DBG-Robots/Rosie/production/bom.csv

Designator | Footprint | Quantity | Value | LCSC Part #
BZ1 | Buzzer_Huaneng_MLT-8530 | 1 | MLT-8530 | C94599
C1 | 0603 | 1 | 10uF
C16, C2, C23, C36, C40, C44 | 0402 | 6 | 100nF
C17, C18, C21, C25, C26, C29, C30, C43 | 0805 | 8 | 22uF
C22, C27, C31, C32, C33, C34, C35, C39, C45, C46, C47 | 0805 | 11 | 10uF
C24, C48 | 0402 | 2 | 4.7nF
C28, C38, C42 | 0402 | 3 | 10nF
C3 | 0402 | 1 | 1uF
C37, C41 | 0402 | 2 | 2.2uF
D10, D2, D9 | 0805 | 3 | green | C2297
D11, D13 | 0603 | 2 | red | C2286
D12 | 0805 | 1 | yellow | C2296
D3 | LED_WS2812B_PLCC4_5.0x5.0mm_P3.2mm | 1 | XL-5050RGBC-2812B | C48586674
D4, D5 | D_SOD-323 | 2 | 1N4148WS | C2128
D6, D7, D8 | D_SMA | 3 | SS34 | C8678
F1 | 1812 | 1 | ASMD1812-300 | C135366
J1 | USB_C_Receptacle_HRO_TYPE-C-31-M-12 | 1 | TYPE-C-31-M-12 | C165948
J10 | PinHeader_1x03_P2.54mm_Vertical | 1 | SERVO2 | C42431788 (cut to length)
J11 | PinHeader_1x04_P2.54mm_Vertical | 1 | UART_LIDAR | C42431788 (cut to length)
J12 | PinHeader_1x06_P2.54mm_Vertical | 1 | GPIO | C42431788 (cut to length)
J2 | JST_XH_B2B-XH-A_1x02_P2.50mm_Vertical | 1 | BATT 4xAA | C2908600
J3 | JST_ZH_B6B-ZR_1x06_P1.50mm_Vertical | 1 | MOTOR1 | C157984
J4 | JST_ZH_B6B-ZR_1x06_P1.50mm_Vertical | 1 | MOTOR2 | C157984
J5 | JST_ZH_B6B-ZR_1x06_P1.50mm_Vertical | 1 | MOTOR3 | C157984
J6 | JST_ZH_B6B-ZR_1x06_P1.50mm_Vertical | 1 | MOTOR4 | C157984
J7 | JST_SH_SM04B-SRSS-TB_1x04-1MP_P1.00mm_Horizontal | 1 | QWIIC | C160404
J8 | PinHeader_1x04_P2.54mm_Vertical | 1 | I2C_2 | C42431788 (cut to length)
J9 | PinHeader_1x03_P2.54mm_Vertical | 1 | SERVO1 | C42431788 (cut to length)
L1, L2 | L_Changjiang_FNR4030S | 2 | 1uH | C167865
Q1, Q2 | SOT-23 | 2 | AO3401A | C15127
Q3 | SOT-23 | 1 | MMBT3904 | C20526
R1, R2, R30, R33, R39 | 0402 | 5 | 10k
R10, R9 | 0402 | 2 | 5.1k
R13, R40 | 0402 | 2 | 200k
R14, R17, R41 | 0402 | 3 | 100k
R24 | 0402 | 1 | 47k
R25, R27 | 0402 | 2 | 15k
R26, R38, R42, R43, R44, R45, R46, R47, R48, R49, R50, R51, R52, R53, R54, R55, R56, R57, R58, R61, R63 | 0402 | 21 | 1k
R28 | 0402 | 1 | 2k
R29 | 0402 | 1 | 12k
R31, R32, R34, R35 | 1206 | 4 | 0.2Ω
R36, R37, R59, R60 | 0402 | 4 | 4.7k
R62 | 0402 | 1 | 470
SW1 | SW_Push_1P1T_XKB_TS-1187A | 1 | EN | C318884
SW2 | SW_Push_1P1T_XKB_TS-1187A | 1 | BOOT | C318884
SW3 | SW_Slide_SPDT_Angled_CK_OS102011MA1Q | 1 | SK12D07VG4 | C393937
U1 | SOT-23-6 | 1 | USBLC6-2SC6 | C7519
U10 | WSON-8-1EP_2x2mm_P0.5mm_EP0.9x1.6mm | 1 | TPS259571DSG | C471038
U3 | VQFN-16-1EP_3x3mm_P0.5mm_EP1.68x1.68mm_ThermalVias_D0.3 | 1 | TPS62130A | C337502
U4 | SOT-563_TI_DRL | 1 | TPS61023DRL | C919459
U5, U7 | SOT-23-5 | 2 | SY6280AAC | C55136
U6 | ESP32-S3-WROOM-1_HandSolder | 1 | ESP32-S3-WROOM-1-N8R2
U8, U9 | HTSSOP-16-1EP_4.4x5mm_P0.65mm_EP3.4x5mm_ThermalVias_D0.3 | 2 | DRV8833PWP | C50506
