DBG-Robots/Rosie/Rosie.kicad_pcb

## KiCad design Rosie.kicad_pcb (2026-11-05)

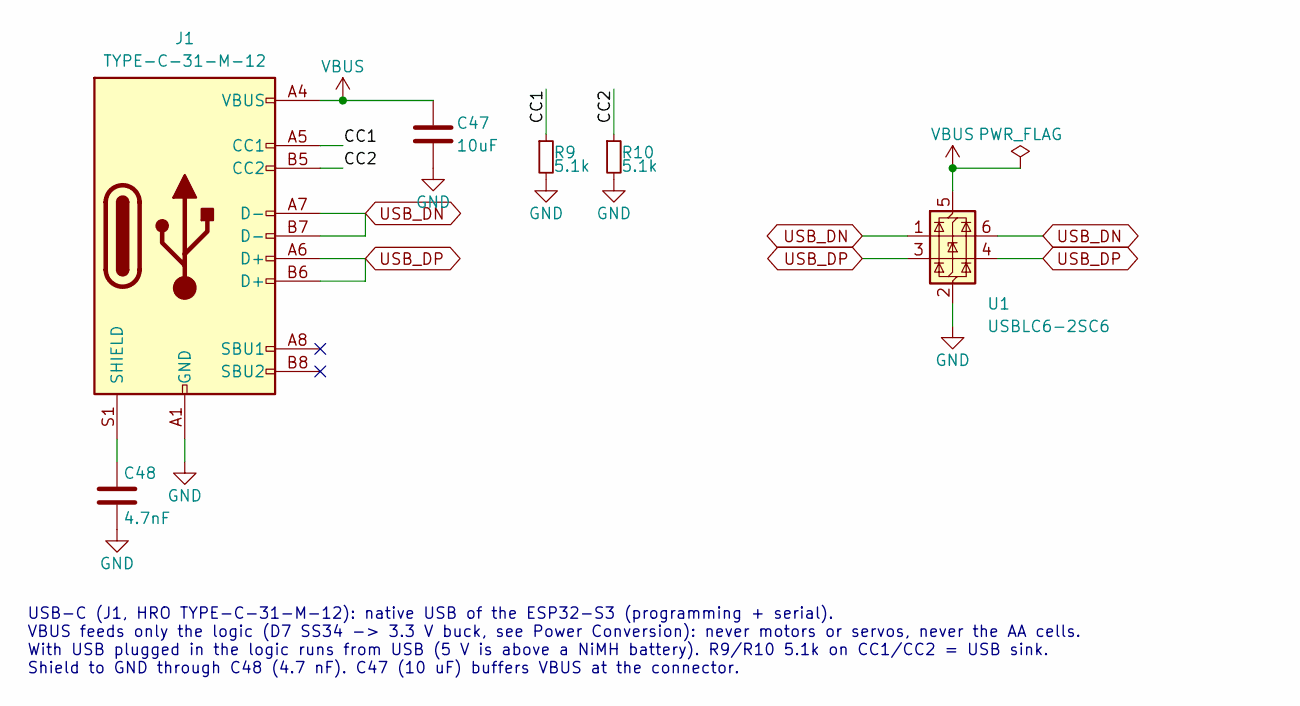
[picture p2: schematic usb.kicad_sch, Rosie]

Parts:
C47: 10uF; C_0805_2012Metric
C48: 4.7nF; C_0402_1005Metric
J1: TYPE-C-31-M-12; USB_C_Receptacle_HRO_TYPE-C-31-M-12; LCSC Part C165948
R9, R10: 5.1k; R_0402_1005Metric
U1: USBLC6-2SC6; SOT-23-6; LCSC Part C7519

Connections:
/USB/CC1: J1.A5 (CC1), R9.1
/USB/CC2: J1.B5 (CC2), R10.1
GND: C47.2, C48.2, J1.A1 (GND), J1.A12 (GND), J1.B1 (GND), J1.B12 (GND), R9.2, R10.2, U1.2 (GND); also elsewhere on the board
unnamed: C48.1, J1.S1 (SHIELD)
USB_DN: J1.A7 (D-), J1.B7 (D-), U1.1 (I/O1), U1.6 (I/O1); also elsewhere on the board
USB_DP: J1.A6 (D+), J1.B6 (D+), U1.3 (I/O2), U1.4 (I/O2); also elsewhere on the board
VBUS: C47.1, J1.A4 (VBUS), J1.A9 (VBUS), J1.B4 (VBUS), J1.B9 (VBUS), U1.5 (VBUS); also elsewhere on the board

Notes on the sheet:
USB-C (J1, HRO TYPE-C-31-M-12): native USB of the ESP32-S3 (programming + serial). VBUS feeds only the logic (D7 SS34 -> 3.3 V buck, see Power Conversion): never motors or servos, never the AA cells. With USB plugged in the logic runs from USB (5 V is above a NiMH battery). R9/R10 5.1k on CC1/CC2 =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

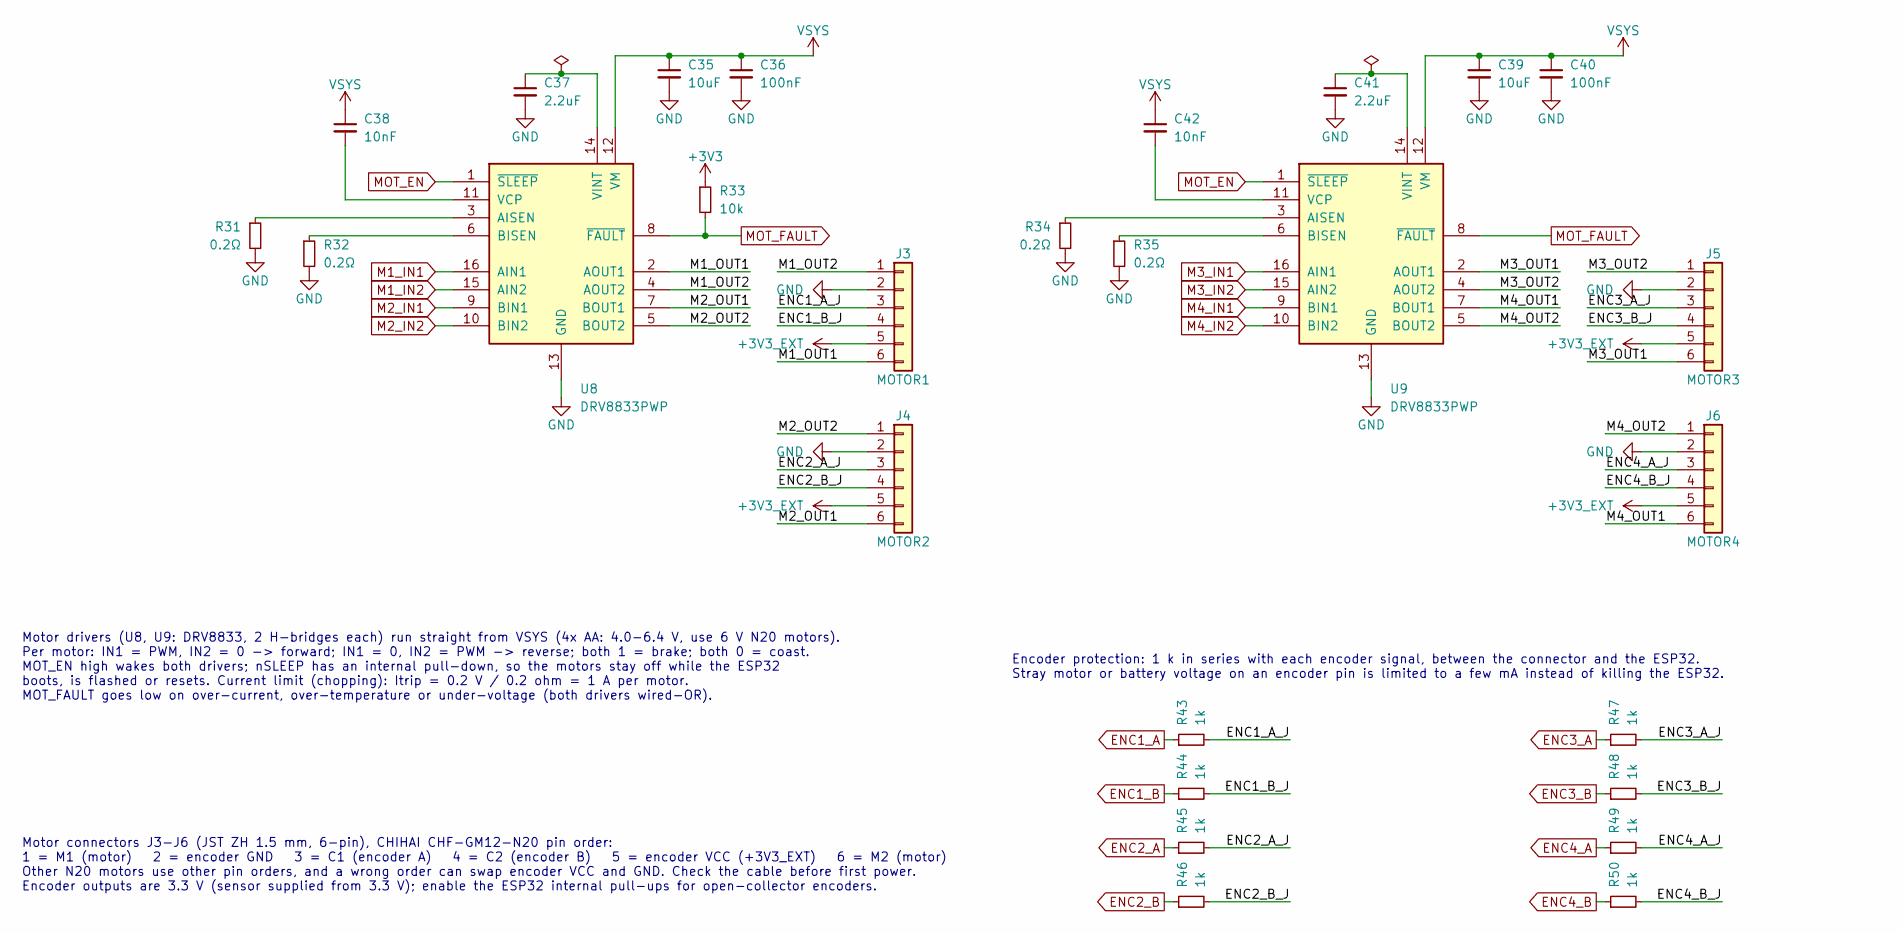
[picture p3: schematic motor_drivers.kicad_sch, Rosie]

Parts:
C35, C39: 10uF; C_0805_2012Metric
C36, C40: 100nF; C_0402_1005Metric
C37, C41: 2.2uF; C_0402_1005Metric
C38, C42: 10nF; C_0402_1005Metric
J3: MOTOR1; JST_ZH_B6B-ZR_1x06_P1.50mm_Vertical; LCSC Part C157984
J4: MOTOR2; JST_ZH_B6B-ZR_1x06_P1.50mm_Vertical; LCSC Part C157984
J5: MOTOR3; JST_ZH_B6B-ZR_1x06_P1.50mm_Vertical; LCSC Part C157984
J6: MOTOR4; JST_ZH_B6B-ZR_1x06_P1.50mm_Vertical; LCSC Part C157984
R31, R32, R34, R35: 0.2Ω; R_1206_3216Metric
R33: 10k; R_0402_1005Metric
R43, R44, R45, R46, R47, R48, R49, R50: 1k; R_0402_1005Metric
U8, U9: DRV8833PWP; HTSSOP-16-1EP_4.4x5mm_P0.65mm_EP3.4x5mm_ThermalVias_D0.3; LCSC Part C50506

Connections:
+3V3: R33.1; also elsewhere on the board
+3V3_EXT: J3.5, J4.5, J5.5, J6.5; also elsewhere on the board
/Motor Drivers/ENC1_A_J: J3.3, R43.2
/Motor Drivers/ENC1_B_J: J3.4, R44.2
/Motor Drivers/ENC2_A_J: J4.3, R45.2
/Motor Drivers/ENC2_B_J: J4.4, R46.2
/Motor Drivers/ENC3_A_J: J5.3, R47.2
/Motor Drivers/ENC3_B_J: J5.4, R48.2
/Motor Drivers/ENC4_A_J: J6.3, R49.2
/Motor Drivers/ENC4_B_J: J6.4, R50.2
/Motor Drivers/M1_OUT1: J3.6, U8.2 (AOUT1)
/Motor Drivers/M1_OUT2: J3.1, U8.4 (AOUT2)
/Motor Drivers/M2_OUT1: J4.6, U8.7 (BOUT1)
/Motor Drivers/M2_OUT2: J4.1, U8.5 (BOUT2)
/Motor Drivers/M3_OUT1: J5.6, U9.2 (AOUT1)
/Motor Drivers/M3_OUT2: J5.1, U9.4 (AOUT2)
/Motor Drivers/M4_OUT1: J6.6, U9.7 (BOUT1)
/Motor Drivers/M4_OUT2: J6.1, U9.5 (BOUT2)
ENC1_A: R43.1; also elsewhere on the board
ENC1_B: R44.1; also elsewhere on the board
ENC2_A: R45.1; also elsewhere on the board
ENC2_B: R46.1; also elsewhere on the board
ENC3_A: R47.1; also elsewhere on the board
ENC3_B: R48.1; also elsewhere on the board
ENC4_A: R49.1; also elsewhere on the board
ENC4_B: R50.1; also elsewhere on the board
GND: C35.2, C36.2, C37.2, C39.2, C40.2, C41.2, J3.2, J4.2, J5.2, J6.2, R31.2, R32.2, R34.2, R35.2, U8.13 (GND), U8.17 (GND), U9.13 (GND), U9.17 (GND); also elsewhere on the board
M1_IN1: U8.16 (AIN1); also elsewhere on the board
M1_IN2: U8.15 (AIN2); also elsewhere on the board
M2_IN1: U8.9 (BIN1); also elsewhere on the board
M2_IN2: U8.10 (BIN2); also elsewhere on the board
M3_IN1: U9.16 (AIN1); also elsewhere on the board
M3_IN2: U9.15 (AIN2); also elsewhere on the board
M4_IN1: U9.9 (BIN1); also elsewhere on the board
M4_IN2: U9.10 (BIN2); also elsewhere on the board
MOT_EN: U8.1 (~SLEEP), U9.1 (~SLEEP); also elsewhere on the board
MOT_FAULT: R33.2, U8.8 (~FAULT), U9.8 (~FAULT); also elsewhere on the board
unnamed: R31.1, U8.3 (AISEN)
unnamed: R32.1, U8.6 (BISEN)
unnamed: C38.2, U8.11 (VCP)
unnamed: C37.1, U8.14 (VINT)
unnamed: R34.1, U9.3 (AISEN)
unnamed: R35.1, U9.6 (BISEN)
unnamed: C42.2, U9.11 (VCP)
unnamed: C41.1, U9.14 (VINT)
VSYS: C35.1, C36.1, C38.1, C39.1, C40.1, C42.1, U8.12 (VM), U9.12 (VM); also elsewhere on the board

Notes on the sheet:
Encoder protection: 1 k in series with each encoder signal, between the connector and the ESP32. Stray motor or battery voltage on an encoder pin is limited to a few mA instead of killing the ESP32.
Motor connectors J3-J6 (JST ZH 1.5 mm, 6-pin), CHIHAI CHF-GM12-N20 pin order: 1 = M1 (motor) 2 = encoder GND 3 = C1 (encoder A) 4 = C2 (encoder B) 5 = encoder VCC (+3V3_EXT) 6 = M2 (motor) Other N20 motors use other pin orders, and a wrong order can swap encoder VCC and GND. Check the cable before 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
Motor drivers (U8, U9: DRV8833, 2 H-bridges each) run straight from VSYS (4x AA: 4.0-6.4 V, use 6 V N20 motors). Per motor: IN1 = PWM, IN2 = 0 -> forward; IN1 = 0, IN2 = PWM -> reverse; both 1 = brake; both 0 = coast. MOT_EN high wakes both drivers; nSLEEP has an internal pull-down, so the motors s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

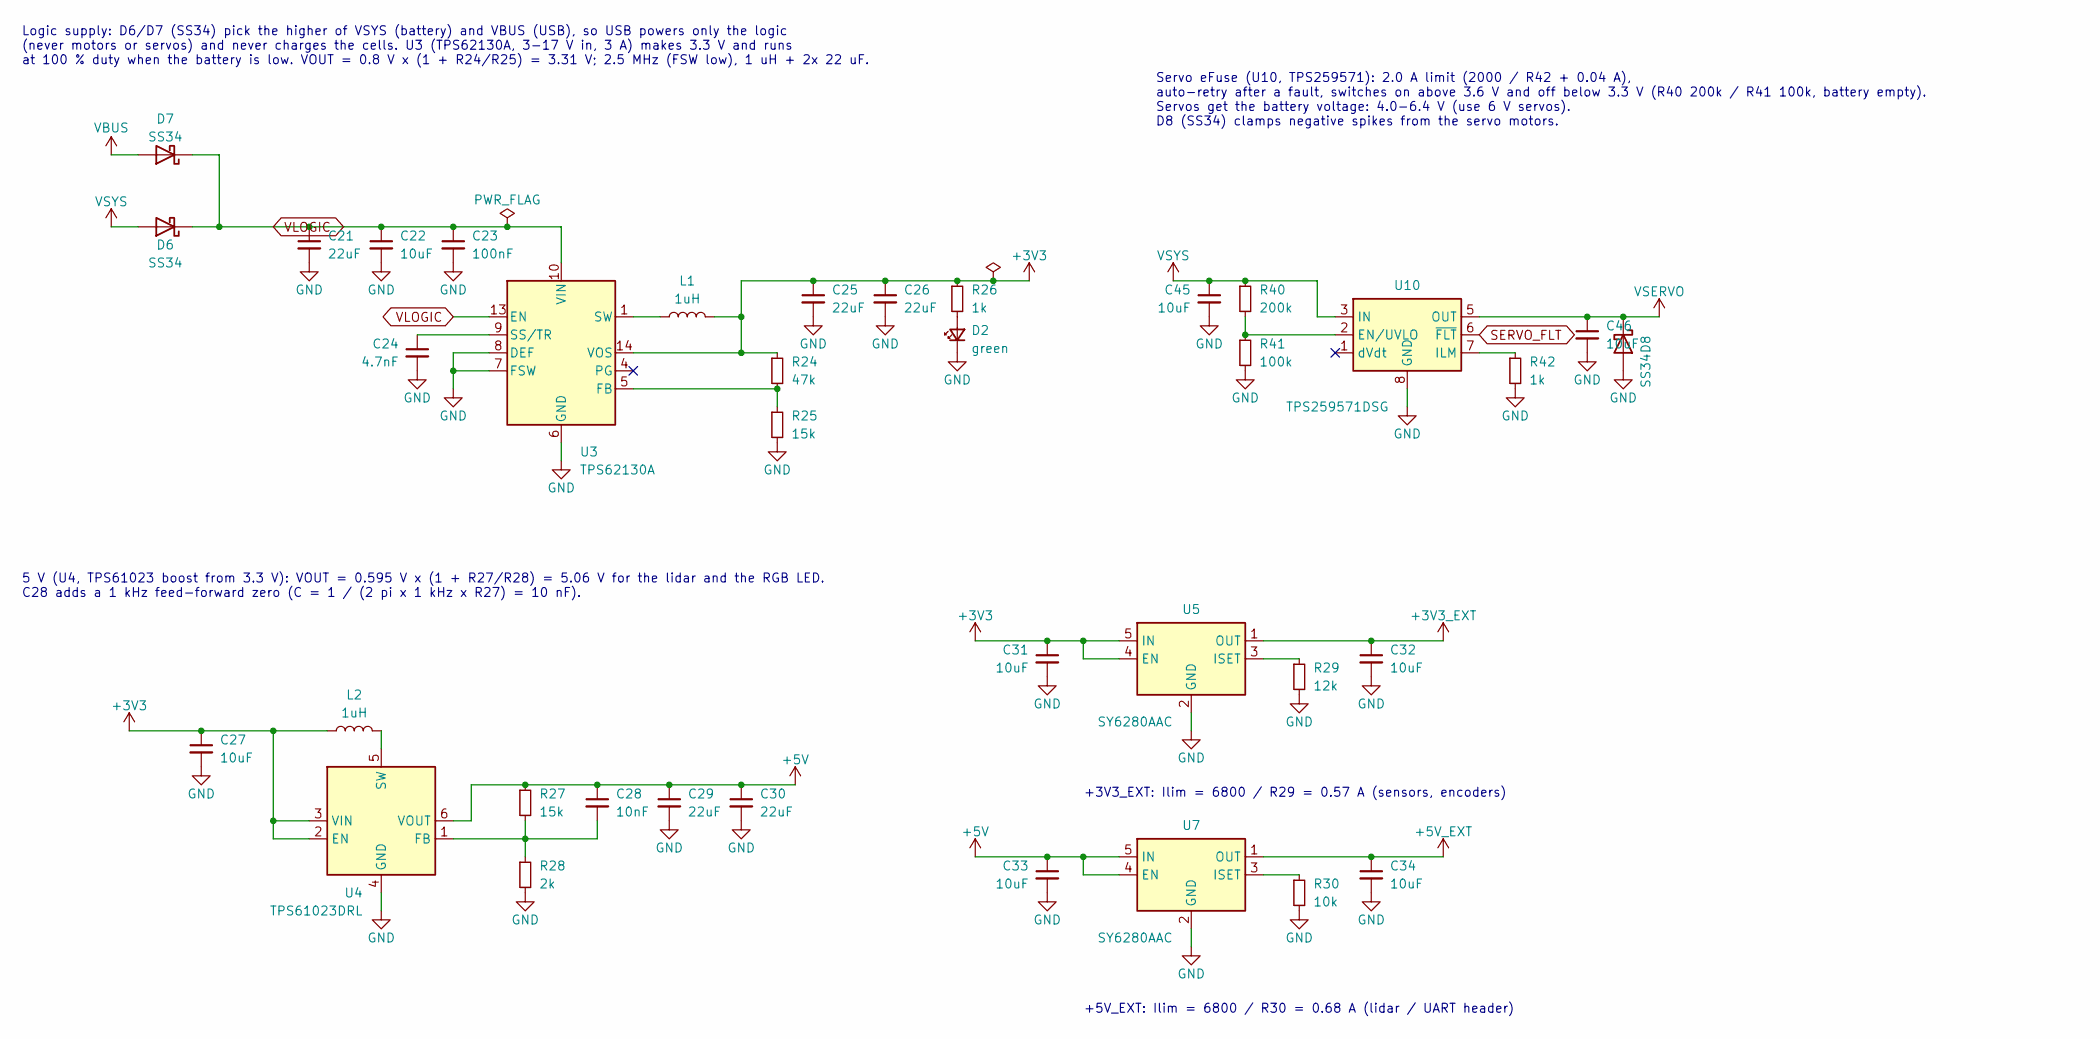
[picture p4: schematic power_conversion.kicad_sch, Rosie]

Parts:
C21, C25, C26, C29, C30: 22uF; C_0805_2012Metric
C22, C27, C31, C32, C33, C34, C45, C46: 10uF; C_0805_2012Metric
C23: 100nF; C_0402_1005Metric
C24: 4.7nF; C_0402_1005Metric
C28: 10nF; C_0402_1005Metric
D2: green; LED_0805_2012Metric; LCSC Part C2297
D6, D7, D8: SS34; D_SMA; LCSC Part C8678
L1, L2: 1uH; L_Changjiang_FNR4030S; LCSC Part C167865
R24: 47k; R_0402_1005Metric
R25, R27: 15k; R_0402_1005Metric
R26, R42: 1k; R_0402_1005Metric
R28: 2k; R_0402_1005Metric
R29: 12k; R_0402_1005Metric
R30: 10k; R_0402_1005Metric
R40: 200k; R_0402_1005Metric
R41: 100k; R_0402_1005Metric
U3: TPS62130A; VQFN-16-1EP_3x3mm_P0.5mm_EP1.68x1.68mm_ThermalVias_D0.3; LCSC Part C337502
U4: TPS61023DRL; SOT-563_TI_DRL; LCSC Part C919459
U5, U7: SY6280AAC; SOT-23-5; LCSC Part C55136
U10: TPS259571DSG; WSON-8-1EP_2x2mm_P0.5mm_EP0.9x1.6mm; LCSC Part C471038

Connections:
+3V3: C25.1, C26.1, C27.1, C31.1, L1.2, L2.1, R24.1, R26.1, U3.14 (VOS), U4.2 (EN), U4.3 (VIN), U5.4 (EN), U5.5 (IN); also elsewhere on the board
+3V3_EXT: C32.1, U5.1 (OUT); also elsewhere on the board
+5V: C28.1, C29.1, C30.1, C33.1, R27.1, U4.6 (VOUT), U7.4 (EN), U7.5 (IN); also elsewhere on the board
+5V_EXT: C34.1, U7.1 (OUT); also elsewhere on the board
GND: C21.2, C22.2, C23.2, C24.2, C25.2, C26.2, C27.2, C29.2, C30.2, C31.2, C32.2, C33.2, C34.2, C45.2, C46.2, D2.1 (K), D8.2 (A), R25.2, R28.2, R29.2, R30.2, R41.2, R42.2, U3.6 (GND), U3.7 (FSW), U3.8 (DEF), U3.15 (GND), U3.16 (GND), U3.17 (GND), U4.4 (GND), U5.2 (GND), U7.2 (GND), U10.8 (GND), U10.9 (GND); also elsewhere on the board
unnamed: D2.2 (A), R26.2
unnamed: L1.1, U3.1 (SW), U3.2 (SW), U3.3 (SW)
unnamed: R24.2, R25.1, U3.5 (FB)
unnamed: C24.1, U3.9 (SS/TR)
unnamed: C28.2, R27.2, R28.1, U4.1 (FB)
unnamed: L2.2, U4.5 (SW)
unnamed: R29.1, U5.3 (ISET)
unnamed: R30.1, U7.3 (ISET)
unnamed: R40.2, R41.1, U10.2 (EN/UVLO)
unnamed: R42.1, U10.7 (ILM)
SERVO_FLT: U10.6 (~FLT); also elsewhere on the board
VBUS: D7.2 (A); also elsewhere on the board
VLOGIC: C21.1, C22.1, C23.1, D6.1 (K), D7.1 (K), U3.10 (VIN), U3.11 (VIN), U3.12 (VIN), U3.13 (EN); also elsewhere on the board
VSERVO: C46.1, D8.1 (K), U10.5 (OUT); also elsewhere on the board
VSYS: C45.1, D6.2 (A), R40.1, U10.3 (IN), U10.4 (IN); also elsewhere on the board

Notes on the sheet:
5 V (U4, TPS61023 boost from 3.3 V): VOUT = 0.595 V x (1 + R27/R28) = 5.06 V for the lidar and the RGB LED. C28 adds a 1 kHz feed-forward zero (C = 1 / (2 pi x 1 kHz x R27) = 10 nF).
Logic supply: D6/D7 (SS34) pick the higher of VSYS (battery) and VBUS (USB), so USB powers only the logic (never motors or servos) and never charges the cells. U3 (TPS62130A, 3-17 V in, 3 A) makes 3.3 V and runs at 100 % duty when the battery is low. VOUT = 0.8 V x (1 + R24/R25) = 3.31 V; 2.5 MHz (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
Servo eFuse (U10, TPS259571): 2.0 A limit (2000 / R42 + 0.04 A), auto-retry after a fault, switches on above 3.6 V and off below 3.3 V (R40 200k / R41 100k, battery empty). Servos get the battery voltage: 4.0-6.4 V (use 6 V servos). D8 (SS34) clamps negative spikes from the servo motors.
+3V3_EXT: Ilim = 6800 / R29 = 0.57 A (sensors, encoders)
+5V_EXT: Ilim = 6800 / R30 = 0.68 A (lidar / UART header)

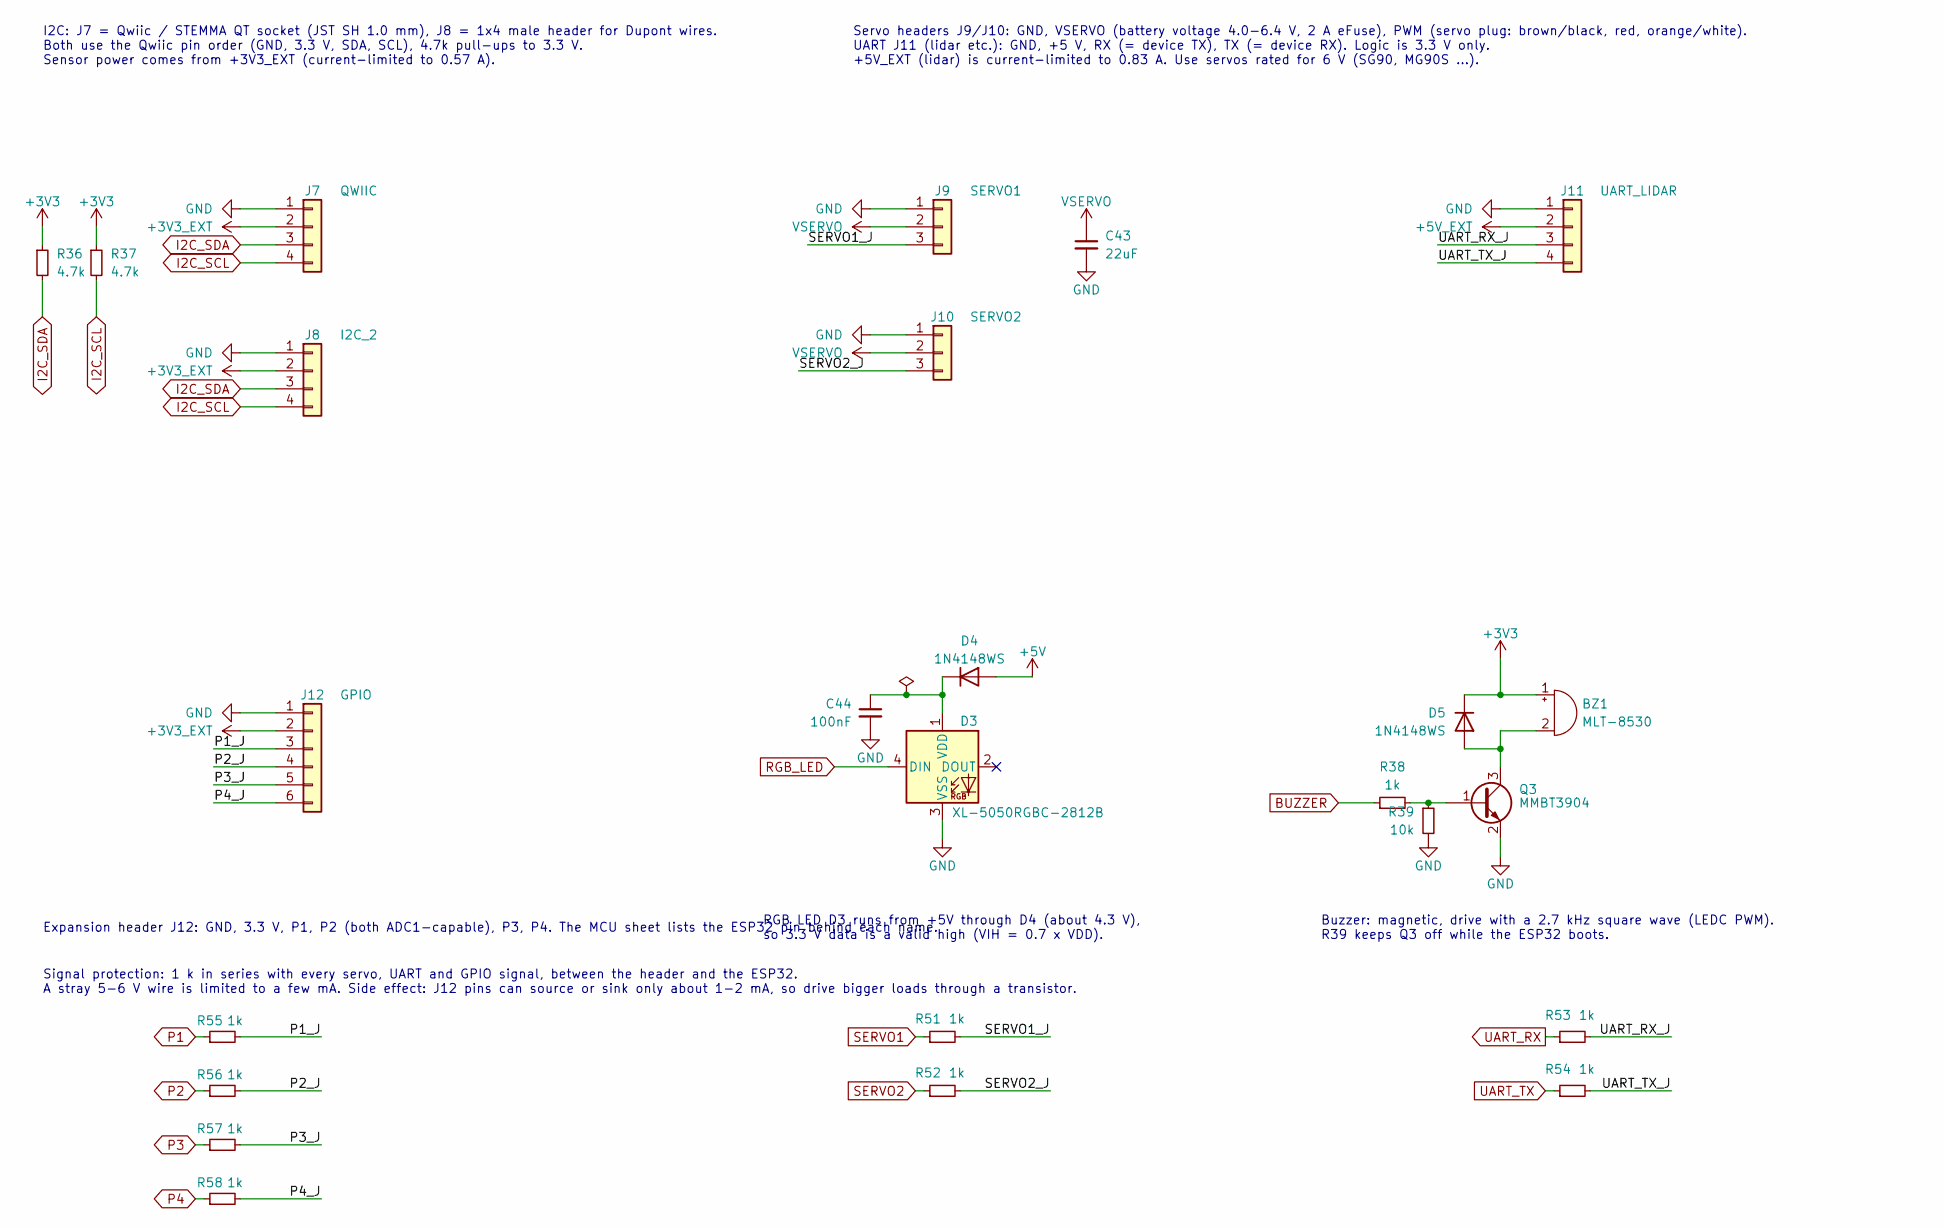
[picture p5: schematic io_peripherals.kicad_sch, Rosie]

Parts:
BZ1: MLT-8530; Buzzer_Huaneng_MLT-8530; LCSC Part C94599
C43: 22uF; C_0805_2012Metric
C44: 100nF; C_0402_1005Metric
D3: XL-5050RGBC-2812B; LED_WS2812B_PLCC4_5.0x5.0mm_P3.2mm; LCSC Part C48586674
D4, D5: 1N4148WS; D_SOD-323; LCSC Part C2128
J7: QWIIC; JST_SH_SM04B-SRSS-TB_1x04-1MP_P1.00mm_Horizontal; LCSC Part C160404
J8: I2C_2; PinHeader_1x04_P2.54mm_Vertical; LCSC Part C42431788 (cut to length)
J9: SERVO1; PinHeader_1x03_P2.54mm_Vertical; LCSC Part C42431788 (cut to length)
J10: SERVO2; PinHeader_1x03_P2.54mm_Vertical; LCSC Part C42431788 (cut to length)
J11: UART_LIDAR; PinHeader_1x04_P2.54mm_Vertical; LCSC Part C42431788 (cut to length)
J12: GPIO; PinHeader_1x06_P2.54mm_Vertical; LCSC Part C42431788 (cut to length)
Q3: MMBT3904; SOT-23; LCSC Part C20526
R36, R37: 4.7k; R_0402_1005Metric
R38, R51, R52, R53, R54, R55, R56, R57, R58: 1k; R_0402_1005Metric
R39: 10k; R_0402_1005Metric

Connections:
+3V3: BZ1.1 (+), D5.1 (K), R36.1, R37.1; also elsewhere on the board
+3V3_EXT: J7.2, J8.2, J12.2; also elsewhere on the board
+5V: D4.2 (A); also elsewhere on the board
+5V_EXT: J11.2; also elsewhere on the board
/IO Peripherals/P1_J: J12.3, R55.2
/IO Peripherals/P2_J: J12.4, R56.2
/IO Peripherals/P3_J: J12.5, R57.2
/IO Peripherals/P4_J: J12.6, R58.2
/IO Peripherals/SERVO1_J: J9.3, R51.2
/IO Peripherals/SERVO2_J: J10.3, R52.2
/IO Peripherals/UART_RX_J: J11.3, R53.2
/IO Peripherals/UART_TX_J: J11.4, R54.2
BUZZER: R38.1; also elsewhere on the board
GND: C43.2, C44.2, D3.3 (VSS), J7.1, J8.1, J9.1, J10.1, J11.1, J12.1, Q3.2 (E), R39.2; also elsewhere on the board
I2C_SCL: J7.4, J8.4, R37.2; also elsewhere on the board
I2C_SDA: J7.3, J8.3, R36.2; also elsewhere on the board
unnamed: BZ1.2 (-), D5.2 (A), Q3.3 (C)
unnamed: C44.1, D3.1 (VDD), D4.1 (K)
unnamed: Q3.1 (B), R38.2, R39.1
P1: R55.1; also elsewhere on the board
P2: R56.1; also elsewhere on the board
P3: R57.1; also elsewhere on the board
P4: R58.1; also elsewhere on the board
RGB_LED: D3.4 (DIN); also elsewhere on the board
SERVO1: R51.1; also elsewhere on the board
SERVO2: R52.1; also elsewhere on the board
UART_RX: R53.1; also elsewhere on the board
UART_TX: R54.1; also elsewhere on the board
VSERVO: C43.1, J9.2, J10.2; also elsewhere on the board

Notes on the sheet:
Buzzer: magnetic, drive with a 2.7 kHz square wave (LEDC PWM). R39 keeps Q3 off while the ESP32 boots.
Servo headers J9/J10: GND, VSERVO (battery voltage 4.0-6.4 V, 2 A eFuse), PWM (servo plug: brown/black, red, orange/white). UART J11 (lidar etc.): GND, +5 V, RX (= device TX), TX (= device RX). Logic is 3.3 V only. +5V_EXT (lidar) is current-limited to 0.83 A. Use servos rated for 6 V (SG90, MG90S 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
Signal protection: 1 k in series with every servo, UART and GPIO signal, between the header and the ESP32. A stray 5-6 V wire is limited to a few mA. Side effect: J12 pins can source or sink only about 1-2 mA, so drive bigger loads through a transistor.
I2C: J7 = Qwiic / STEMMA QT socket (JST SH 1.0 mm), J8 = 1x4 male header for Dupont wires. Both use the Qwiic pin order (GND, 3.3 V, SDA, SCL), 4.7k pull-ups to 3.3 V. Sensor power comes from +3V3_EXT (current-limited to 0.57 A).
RGB LED D3 runs from +5V through D4 (about 4.3 V), so 3.3 V data is a valid high (VIH = 0.7 x VDD).
Expansion header J12: GND, 3.3 V, P1, P2 (both ADC1-capable), P3, P4. The MCU sheet lists the ESP32 pin behind each name.

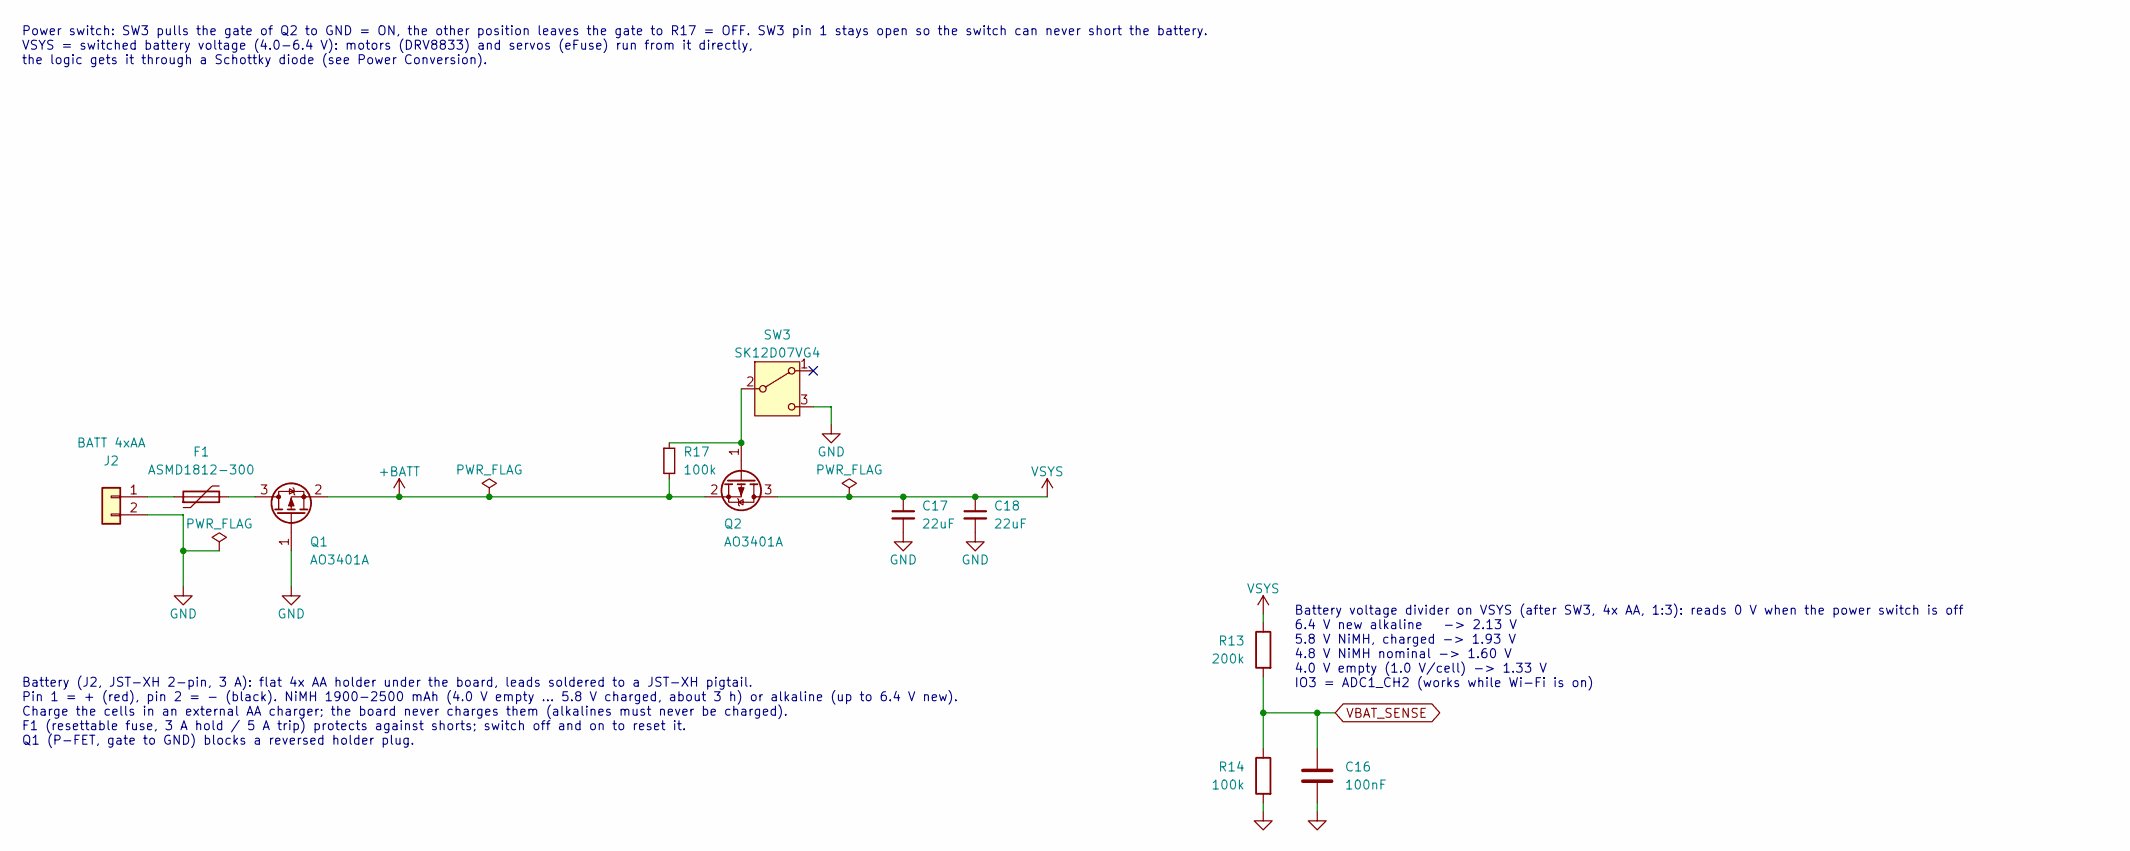
[picture p6: schematic power_input.kicad_sch, Rosie]

Parts:
C16: 100nF; C_0402_1005Metric
C17, C18: 22uF; C_0805_2012Metric
F1: ASMD1812-300; Fuse_1812_4532Metric; LCSC Part C135366
J2: BATT 4xAA; JST_XH_B2B-XH-A_1x02_P2.50mm_Vertical; LCSC Part C2908600
Q1, Q2: AO3401A; SOT-23; LCSC Part C15127
R13: 200k; R_0402_1005Metric
R14, R17: 100k; R_0402_1005Metric
SW3: SK12D07VG4; SW_Slide_SPDT_Angled_CK_OS102011MA1Q; LCSC Part C393937

Connections:
+BATT: Q1.2 (S), Q2.2 (S), R17.2; also elsewhere on the board
GND: C16.2, C17.2, C18.2, J2.2, Q1.1 (G), R14.2, SW3.3 (C); also elsewhere on the board
unnamed: F1.1, J2.1
unnamed: F1.2, Q1.3 (D)
unnamed: Q2.1 (G), R17.1, SW3.2 (B)
VBAT_SENSE: C16.1, R13.2, R14.1; also elsewhere on the board
VSYS: C17.1, C18.1, Q2.3 (D), R13.1; also elsewhere on the board

Notes on the sheet:
Power switch: SW3 pulls the gate of Q2 to GND = ON, the other position leaves the gate to R17 = OFF. SW3 pin 1 stays open so the switch can never short the battery. VSYS = switched battery voltage (4.0-6.4 V): motors (DRV8833) and servos (eFuse) run from it directly, the logic gets it through a Sch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
Battery voltage divider on VSYS (after SW3, 4x AA, 1:3): reads 0 V when the power switch is off 6.4 V new alkaline -> 2.13 V 5.8 V NiMH, charged -> 1.93 V 4.8 V NiMH nominal -> 1.60 V 4.0 V empty (1.0 V/cell) -> 1.33 V IO3 = ADC1_CH2 (works while Wi-Fi is on)
Battery (J2, JST-XH 2-pin, 3 A): flat 4x AA holder under the board, leads soldered to a JST-XH pigtail. Pin 1 = + (red), pin 2 = - (black). NiMH 1900-2500 mAh (4.0 V empty ... 5.8 V charged, about 3 h) or alkaline (up to 6.4 V new). Charge the cells in an external AA charger; the board never charge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

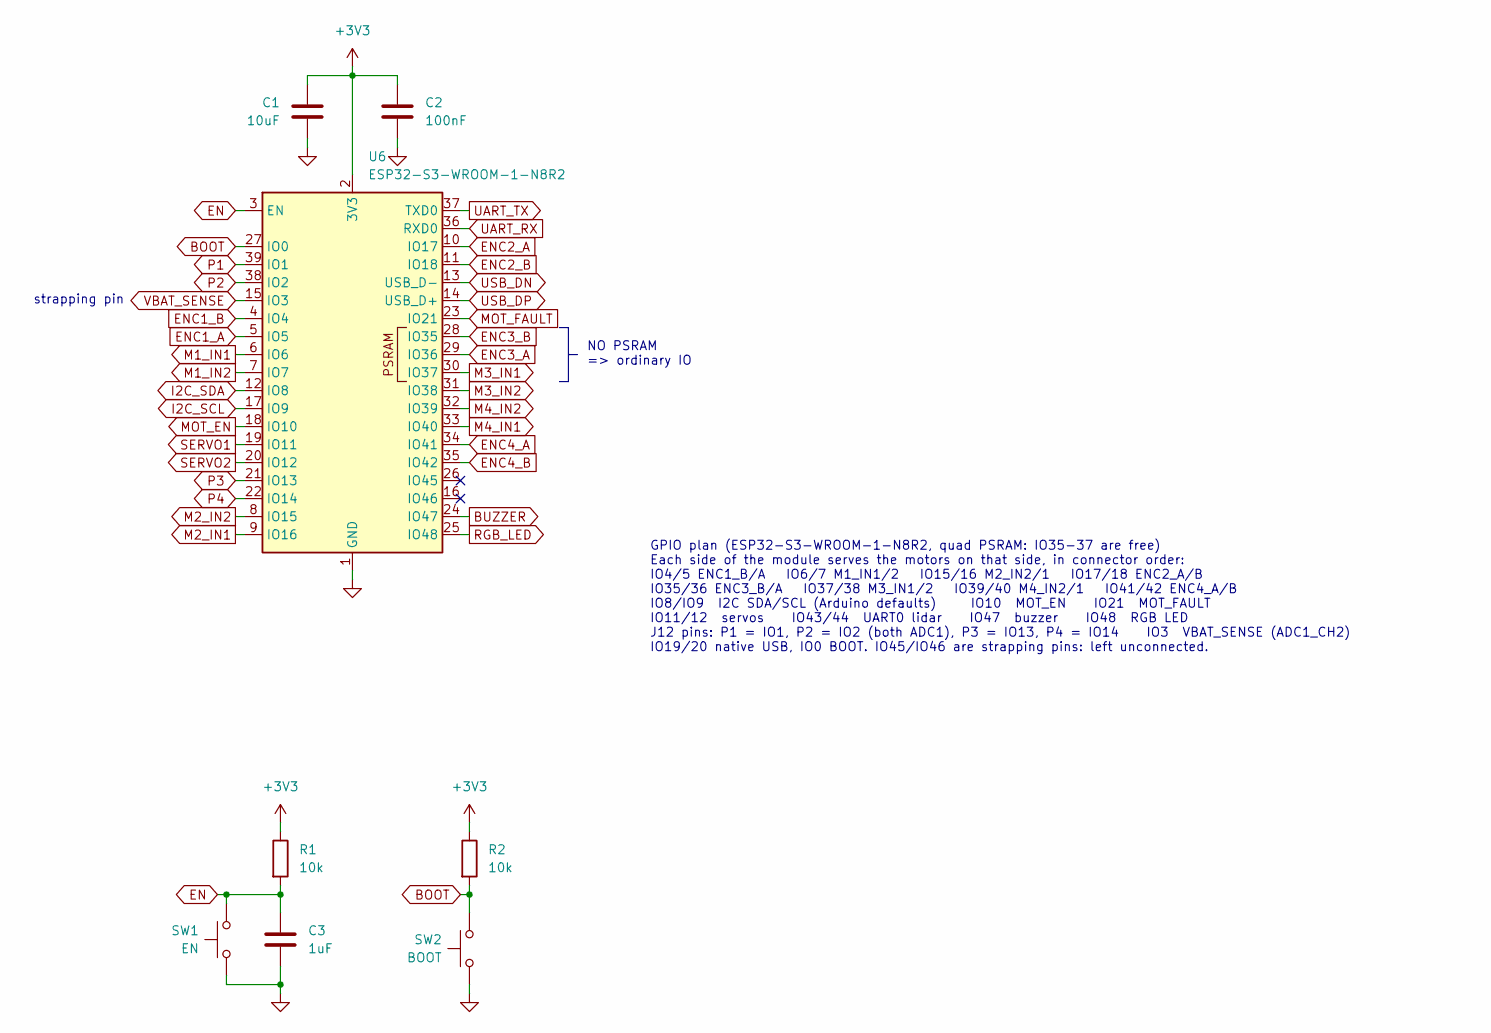
[picture p7: schematic mcu.kicad_sch, Rosie]

Parts:
C1: 10uF; C_0603_1608Metric
C2: 100nF; C_0402_1005Metric
C3: 1uF; C_0402_1005Metric
R1, R2: 10k; R_0402_1005Metric
SW1: EN; SW_Push_1P1T_XKB_TS-1187A; LCSC Part C318884
SW2: BOOT; SW_Push_1P1T_XKB_TS-1187A; LCSC Part C318884
U6: ESP32-S3-WROOM-1-N8R2; ESP32-S3-WROOM-1_HandSolder

Connections:
+3V3: C1.1, C2.1, R1.1, R2.1, U6.2 (3V3); also elsewhere on the board
BOOT: R2.2, SW2.2, U6.27 (IO0); also elsewhere on the board
BUZZER: U6.24 (IO47); also elsewhere on the board
EN: C3.1, R1.2, SW1.2, U6.3 (EN); also elsewhere on the board
ENC1_A: U6.5 (IO5); also elsewhere on the board
ENC1_B: U6.4 (IO4); also elsewhere on the board
ENC2_A: U6.10 (IO17); also elsewhere on the board
ENC2_B: U6.11 (IO18); also elsewhere on the board
ENC3_A: U6.29 (IO36); also elsewhere on the board
ENC3_B: U6.28 (IO35); also elsewhere on the board
ENC4_A: U6.34 (IO41); also elsewhere on the board
ENC4_B: U6.35 (IO42); also elsewhere on the board
GND: C1.2, C2.2, C3.2, SW1.1, SW2.1, U6.1 (GND), U6.40 (GND), U6.41 (GND); also elsewhere on the board
I2C_SCL: U6.17 (IO9); also elsewhere on the board
I2C_SDA: U6.12 (IO8); also elsewhere on the board
M1_IN1: U6.6 (IO6); also elsewhere on the board
M1_IN2: U6.7 (IO7); also elsewhere on the board
M2_IN1: U6.9 (IO16); also elsewhere on the board
M2_IN2: U6.8 (IO15); also elsewhere on the board
M3_IN1: U6.30 (IO37); also elsewhere on the board
M3_IN2: U6.31 (IO38); also elsewhere on the board
M4_IN1: U6.33 (IO40); also elsewhere on the board
M4_IN2: U6.32 (IO39); also elsewhere on the board
MOT_EN: U6.18 (IO10); also elsewhere on the board
MOT_FAULT: U6.23 (IO21); also elsewhere on the board
P1: U6.39 (IO1); also elsewhere on the board
P2: U6.38 (IO2); also elsewhere on the board
P3: U6.21 (IO13); also elsewhere on the board
P4: U6.22 (IO14); also elsewhere on the board
RGB_LED: U6.25 (IO48); also elsewhere on the board
SERVO1: U6.19 (IO11); also elsewhere on the board
SERVO2: U6.20 (IO12); also elsewhere on the board
UART_RX: U6.36 (RXD0); also elsewhere on the board
UART_TX: U6.37 (TXD0); also elsewhere on the board
USB_DN: U6.13 (USB_D-); also elsewhere on the board
USB_DP: U6.14 (USB_D+); also elsewhere on the board
VBAT_SENSE: U6.15 (IO3); also elsewhere on the board

Notes on the sheet:
GPIO plan (ESP32-S3-WROOM-1-N8R2, quad PSRAM: IO35-37 are free) Each side of the module serves the motors on that side, in connector order: IO4/5 ENC1_B/A IO6/7 M1_IN1/2 IO15/16 M2_IN2/1 IO17/18 ENC2_A/B IO35/36 ENC3_B/A IO37/38 M3_IN1/2 IO39/40 M4_IN2/1 IO41/42 ENC4_A/B IO8/IO9 I2C SDA/SCL (Arduin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
NO PSRAM => ordinary IO
strapping pin

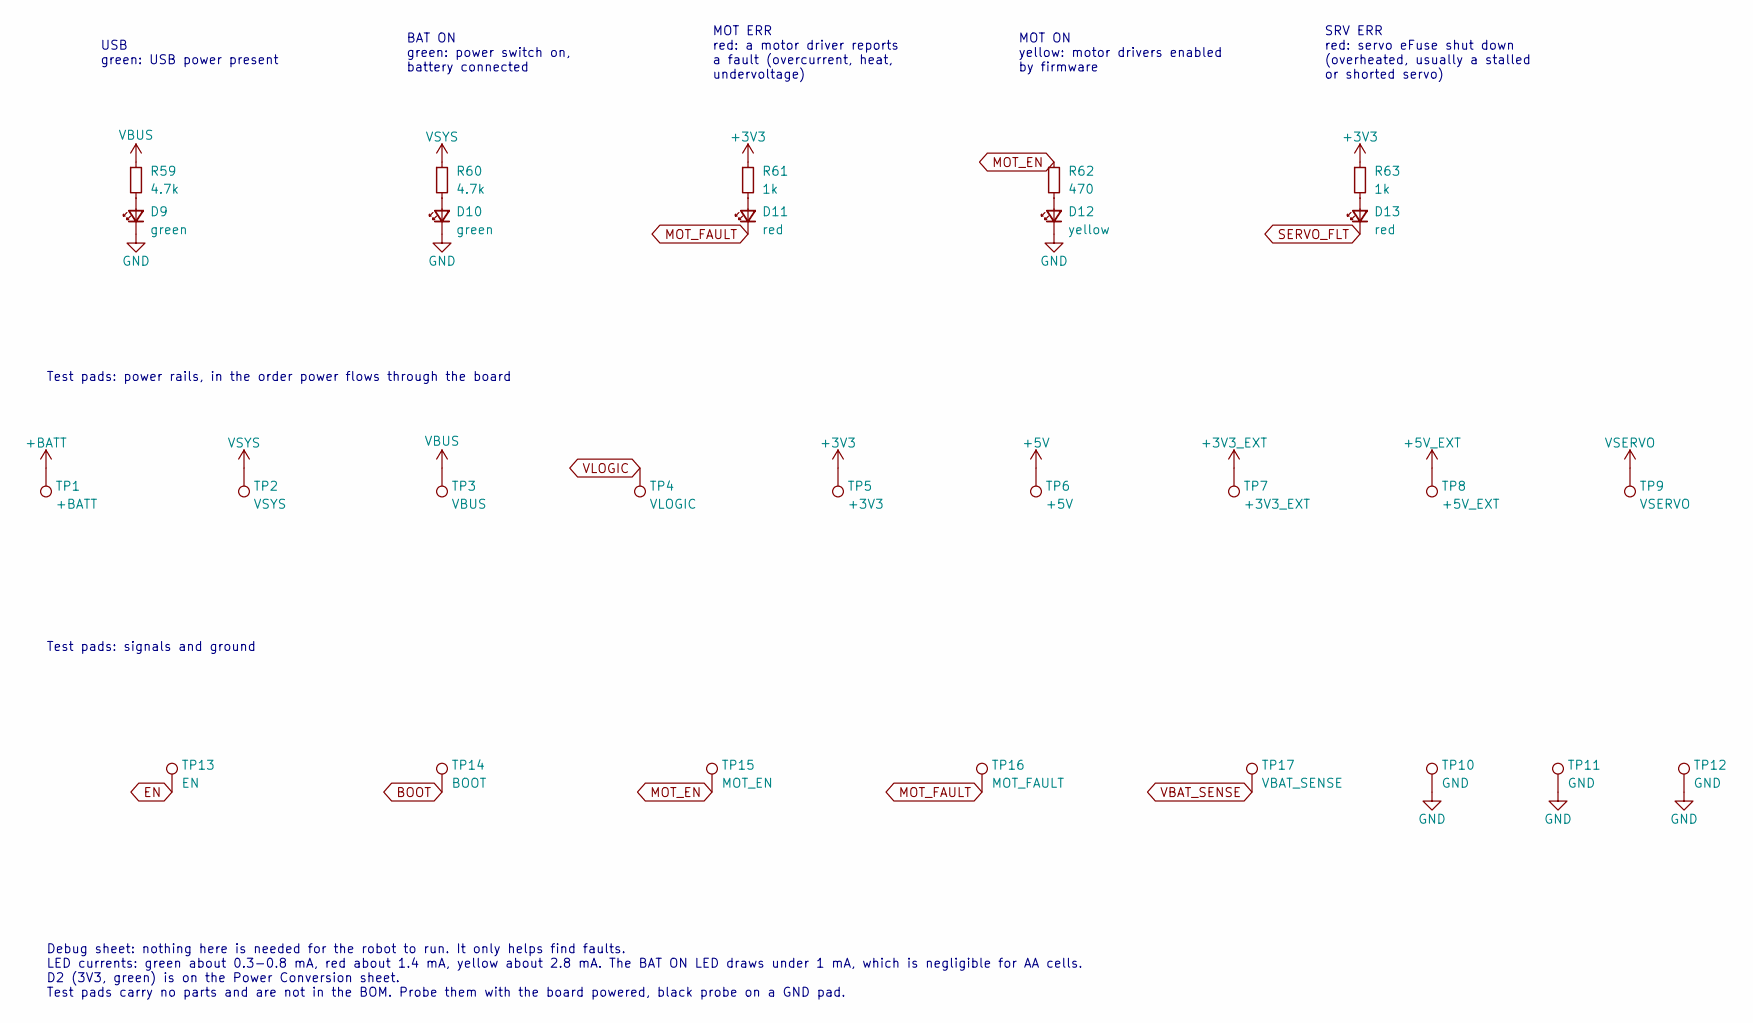
[picture p8: schematic debug.kicad_sch, Rosie]

Parts:
D9, D10: green; LED_0805_2012Metric; LCSC Part C2297
D11, D13: red; LED_0603_1608Metric; LCSC Part C2286
D12: yellow; LED_0805_2012Metric; LCSC Part C2296
R59, R60: 4.7k; R_0402_1005Metric
R61, R63: 1k; R_0402_1005Metric
R62: 470; R_0402_1005Metric
TP1: +BATT; TestPoint_Pad_D1.5mm
TP2: VSYS; TestPoint_Pad_D1.5mm
TP3: VBUS; TestPoint_Pad_D1.5mm
TP4: VLOGIC; TestPoint_Pad_D1.5mm
TP5: +3V3; TestPoint_Pad_D1.5mm
TP6: +5V; TestPoint_Pad_D1.5mm
TP7: +3V3_EXT; TestPoint_Pad_D1.5mm
TP8: +5V_EXT; TestPoint_Pad_D1.5mm
TP9: VSERVO; TestPoint_Pad_D1.5mm
TP10, TP11, TP12: GND; TestPoint_Pad_D1.5mm
TP13: EN; TestPoint_Pad_D1.5mm
TP14: BOOT; TestPoint_Pad_D1.5mm
TP15: MOT_EN; TestPoint_Pad_D1.5mm
TP16: MOT_FAULT; TestPoint_Pad_D1.5mm
TP17: VBAT_SENSE; TestPoint_Pad_D1.5mm

Connections:
+3V3: R61.1, R63.1, TP5.1; also elsewhere on the board
+3V3_EXT: TP7.1; also elsewhere on the board
+5V: TP6.1; also elsewhere on the board
+5V_EXT: TP8.1; also elsewhere on the board
+BATT: TP1.1; also elsewhere on the board
BOOT: TP14.1; also elsewhere on the board
EN: TP13.1; also elsewhere on the board
GND: D9.1 (K), D10.1 (K), D12.1 (K), TP10.1, TP11.1, TP12.1; also elsewhere on the board
MOT_EN: R62.1, TP15.1; also elsewhere on the board
MOT_FAULT: D11.1 (K), TP16.1; also elsewhere on the board
unnamed: D9.2 (A), R59.2
unnamed: D10.2 (A), R60.2
unnamed: D11.2 (A), R61.2
unnamed: D12.2 (A), R62.2
unnamed: D13.2 (A), R63.2
SERVO_FLT: D13.1 (K); also elsewhere on the board
VBAT_SENSE: TP17.1; also elsewhere on the board
VBUS: R59.1, TP3.1; also elsewhere on the board
VLOGIC: TP4.1; also elsewhere on the board
VSERVO: TP9.1; also elsewhere on the board
VSYS: R60.1, TP2.1; also elsewhere on the board

Notes on the sheet:
USB green: USB power present
BAT ON green: power switch on, battery connected
MOT ERR red: a motor driver reports a fault (overcurrent, heat, undervoltage)
MOT ON yellow: motor drivers enabled by firmware
SRV ERR red: servo eFuse shut down (overheated, usually a stalled or shorted servo)
Test pads: power rails, in the order power flows through the board
Test pads: signals and ground
Debug sheet: nothing here is needed for the robot to run. It only helps find faults. LED currents: green about 0.3-0.8 mA, red about 1.4 mA, yellow about 2.8 mA. The BAT ON LED draws under 1 mA, which is negligible for AA cells. D2 (3V3, green) is on the Power Conversion sheet. Test pads carry no p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
