DBG-Robots/Rosie/Rosie.kicad_pcb

## KiCad design Rosie.kicad_pcb (continued)

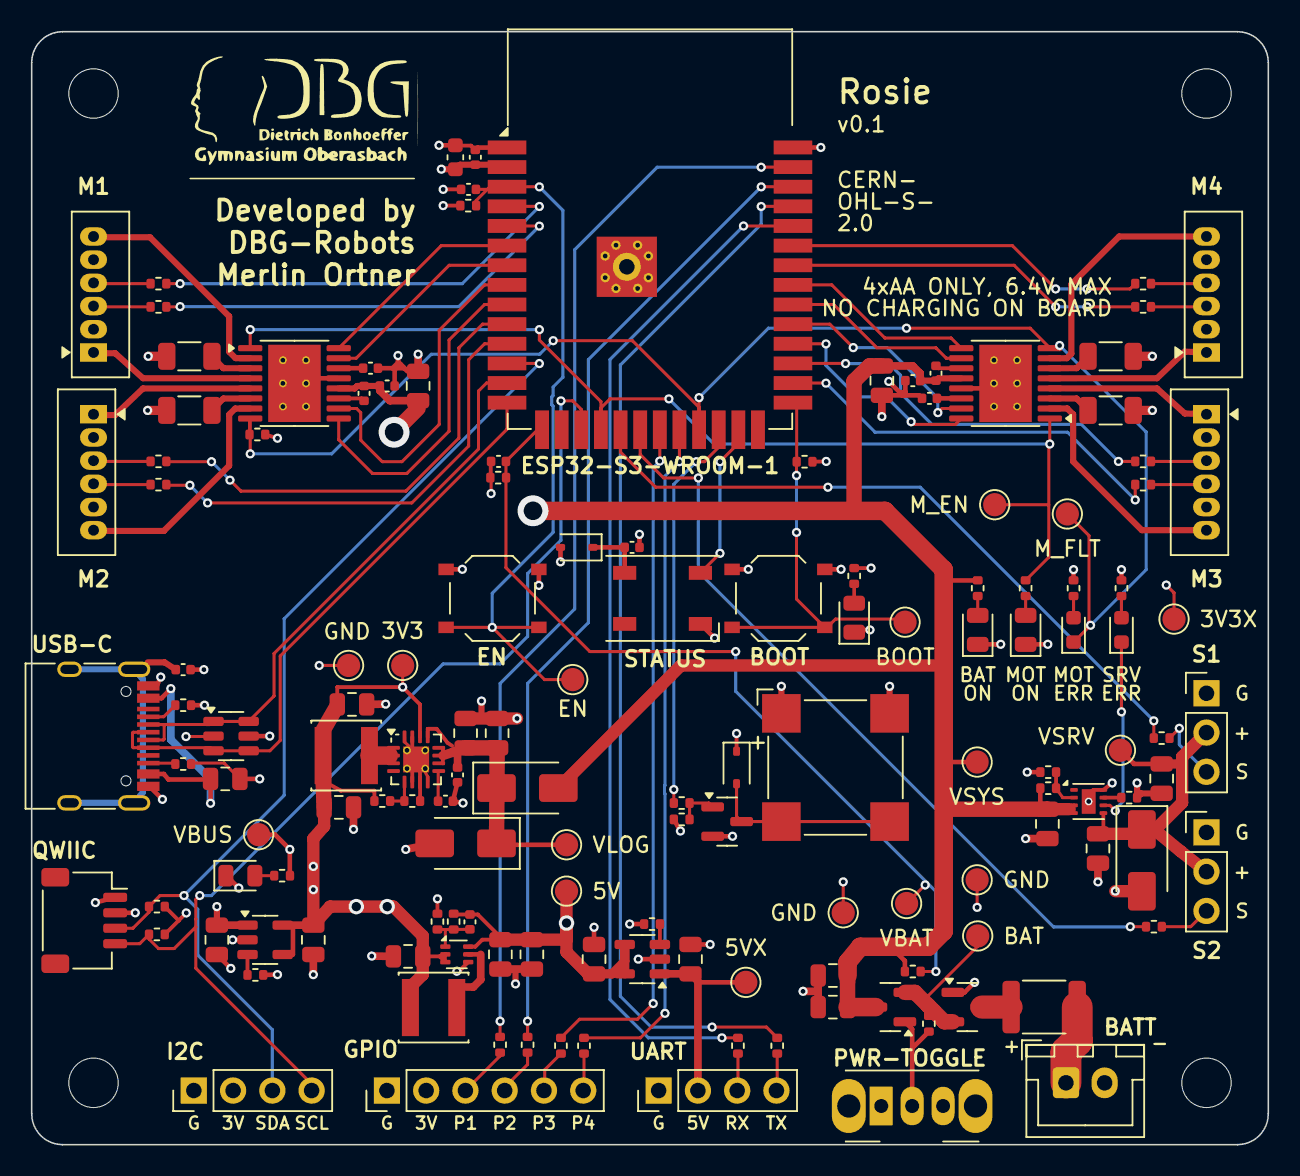
[picture p9: board Rosie.kicad_pcb from above]

Board: 4 copper layers, 80.0 x 72.0 mm, 145 parts (0 on the bottom side), 102 nets.

Other parts of the board:
H1, H2, H3, H4: MountingHole_3.2mm_M3
